AD7ZJ/NixieClock/README.md

# Single Tube IN-18 Nixie Clock
This is a single tube nixie clock based on a PIC16F690.  The board layout is 2 layers and easy to etch yourself if you like. 
I am building this using MPLab X and the XC8 compiler.
