AD7ZJ/NixieClock/Hardware/nixieClock.brd

## EAGLE design Hardware/nixieClock.brd (2017-02-04)

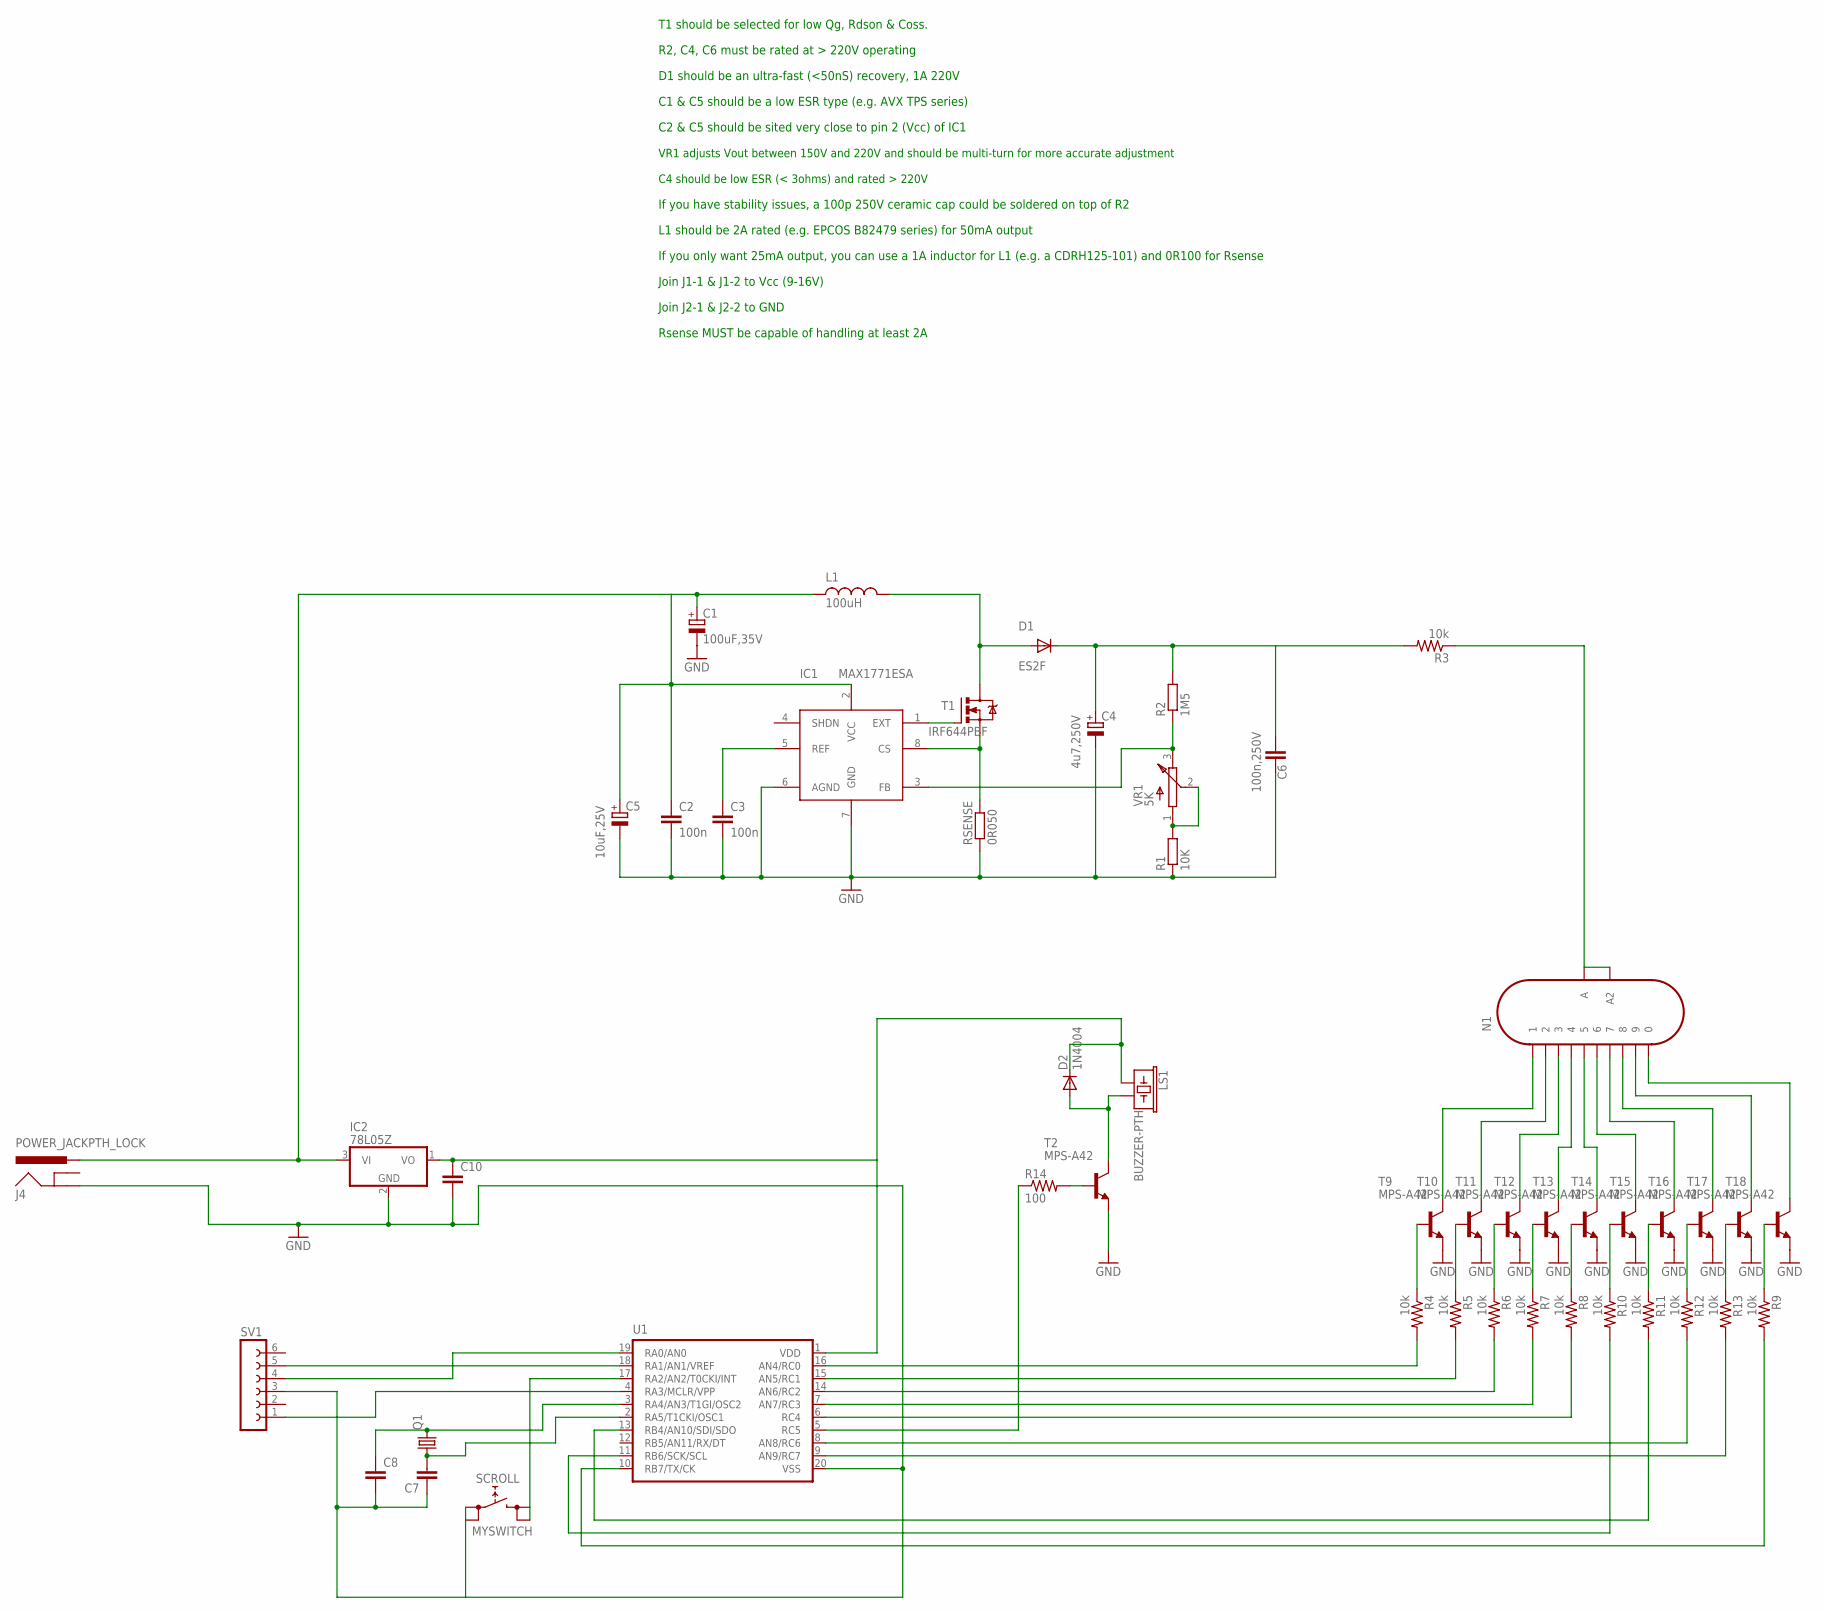
[picture p1: schematic nixieClock.sch]

Parts:
C1: 100uF,35V; C-EIA-7343
C2, C3: 100n; C0805
C4: 4u7,250V; NICHICON-UJ-12
C5: 10uF,25V; C-EIA-7343
C6: 100n,250V; C2420
C7, C8, C10: C2,5-3; C2.5-3
D1: ES2F; SMC
D2: 1N4004; DO41-10
IC1: MAX1771ESA; SO-8
IC2: 78L05Z; TO92
J4: POWER_JACKPTH_LOCK; POWER_JACK_PTH_LOCK
L1: 100uH; L-B82479
LS1: BUZZER-PTH; BUZZER-12MM
N1: IN-18
Q1: CRYSTALTC26V; TC26V
R1: 10K; R0805
R2: 1M5; R2512
R3, R4, R5, R6, R7, R8, R9, R10, R11, R12, R13: 10k; 0207/2V
R14: 100; 0207/2V
RSENSE: 0R050; R2010
SCROLL: MYSWITCH
SV1: FE06-1; FE06
T1: IRF644PBF; TO220BV
T2, T9, T10, T11, T12, T13, T14, T15, T16, T17, T18: MPS-A42; TO92-CBE
U1: PIC16F6XX; DIL20
VR1: 5K; BOURNS-3214W

Connections:
EXT: IC1.1 (EXT), T1.G
GND: C1.-, C2.2, C3.2, C4.1 (-), C5.-, C6.P$2 (2), C7.1, C8.2, C10.2, IC1.6 (AGND), IC1.7 (GND), IC2.2 (GND), J4.GND, R1.1, RSENSE.1, SCROLL.A0 (0), SCROLL.A1 (0), SV1.3, T2.E, T9.E, T10.E, T11.E, T12.E, T13.E, T14.E, T15.E, T16.E, T17.E, T18.E, U1.20 (VSS)
unnamed: N1.1, T9.C
unnamed: IC1.8 (CS), RSENSE.2, T1.S
unnamed: R1.2, VR1.1 (A), VR1.2 (W)
unnamed: SV1.1, U1.4 (RA3/MCLR/VPP)
unnamed: R8.2, U1.6 (RC4)
unnamed: R4.1, T9.B
unnamed: IC1.3 (FB), R2.1, VR1.3 (B)
unnamed: R5.1, T10.B
unnamed: R4.2, U1.16 (AN4/RC0)
unnamed: R5.2, U1.15 (AN5/RC1)
unnamed: R6.2, U1.14 (AN6/RC2)
unnamed: R7.2, U1.7 (AN7/RC3)
unnamed: SV1.4, U1.19 (RA0/AN0)
unnamed: D1.A, L1.P$2 (2), T1.D
unnamed: SV1.5, U1.18 (RA1/AN1/VREF)
unnamed: C3.1, IC1.5 (REF)
unnamed: R14.1, U1.5 (RC5)
unnamed: R12.2, U1.8 (AN8/RC6)
unnamed: R6.1, T11.B
unnamed: R13.2, U1.9 (AN9/RC7)
unnamed: R7.1, T12.B
unnamed: R8.1, T13.B
unnamed: C7.2, Q1.1, U1.2 (RA5/T1CKI/OSC1)
unnamed: R10.1, T14.B
unnamed: C8.1, Q1.2, U1.3 (RA4/AN3/T1GI/OSC2)
unnamed: R11.1, T15.B
unnamed: R12.1, T16.B
unnamed: R13.1, T17.B
unnamed: C10.1, D2.C, IC2.1 (VO), LS1.+ (1), U1.1 (VDD)
unnamed: R9.1, T18.B
unnamed: R10.2, U1.11 (RB6/SCK/SCL)
unnamed: R9.2, U1.10 (RB7/TX/CK)
unnamed: SCROLL.B0 (1), SCROLL.B1 (1), U1.17 (RA2/AN2/T0CKI/INT)
unnamed: N1.2, T10.C
unnamed: R11.2, U1.13 (RB4/AN10/SDI/SDO)
unnamed: D2.A, LS1.- (2), T2.C
unnamed: R14.2, T2.B
unnamed: N1.3, T11.C
unnamed: N1.4, T12.C
unnamed: N1.5, T13.C
unnamed: N1.6, T14.C
unnamed: N1.7, T15.C
unnamed: N1.8, T16.C
unnamed: N1.9, T17.C
unnamed: N1.0, T18.C
unnamed: N1.A, N1.A2, R3.1
PWR: C1.+, C2.1, C5.+, IC1.2 (VCC), IC2.3 (VI), J4.PWR, L1.P$1 (1)
VOUT: C4.2 (+), C6.P$1 (1), D1.C, R2.2, R3.2

Notes on the sheet:
R2, C4, C6 must be rated at > 220V operating
D1 should be an ultra-fast (<50nS) recovery, 1A 220V
C1 & C5 should be a low ESR type (e.g. AVX TPS series)
C2 & C5 should be sited very close to pin 2 (Vcc) of IC1
VR1 adjusts Vout between 150V and 220V and should be multi-turn for more accurate adjustment
C4 should be low ESR (< 3ohms) and rated > 220V
If you have stability issues, a 100p 250V ceramic cap could be soldered on top of R2
L1 should be 2A rated (e.g. EPCOS B82479 series) for 50mA output
Join J1-1 & J1-2 to Vcc (9-16V)
Join J2-1 & J2-2 to GND
T1 should be selected for low Qg, Rdson & Coss.
Rsense MUST be capable of handling at least 2A
If you only want 25mA output, you can use a 1A inductor for L1 (e.g. a CDRH125-101) and 0R100 for Rsense

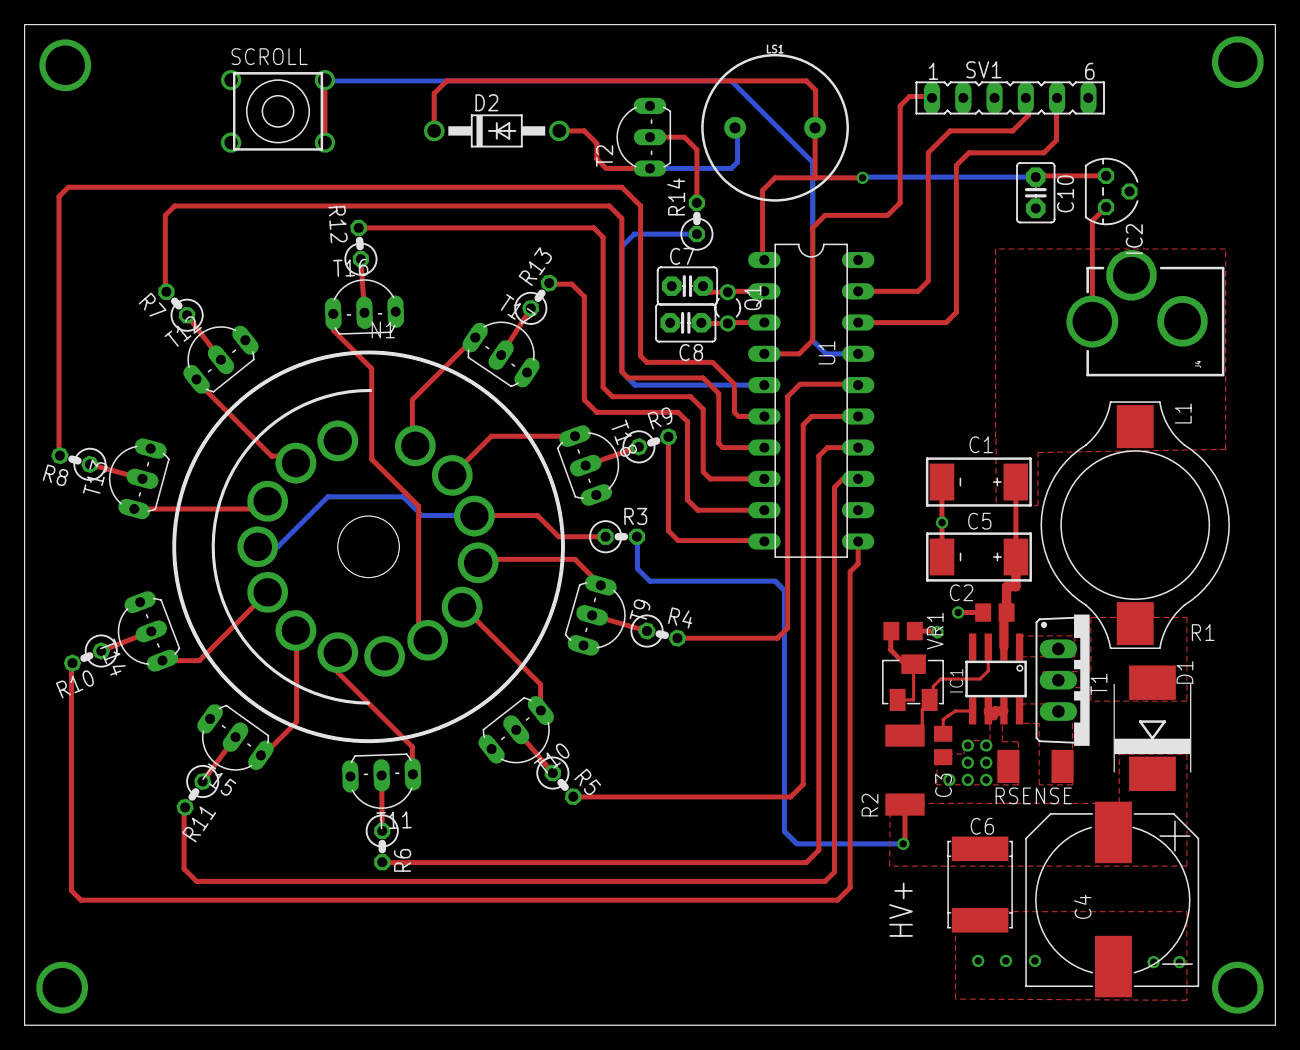
[picture p2: board nixieClock.brd from above]

Board: 2 copper layers, 101.6 x 81.3 mm, 49 parts (0 on the bottom side), 50 nets.
