AD7ZJ/NixieClock/(commit log)

2017-02-04 Check in initial schematic and board layout
    [nixieClock.brd, nixieClock.sch]
2026-01-09 Rework for latest XC8. First cut at adding cal routine.
    [main.c]
